acastles91/menelaos/menelaos/menelaos-v2.kicad_pcb

## KiCad design menelaos/menelaos-v2.kicad_pcb (2021-11-27)

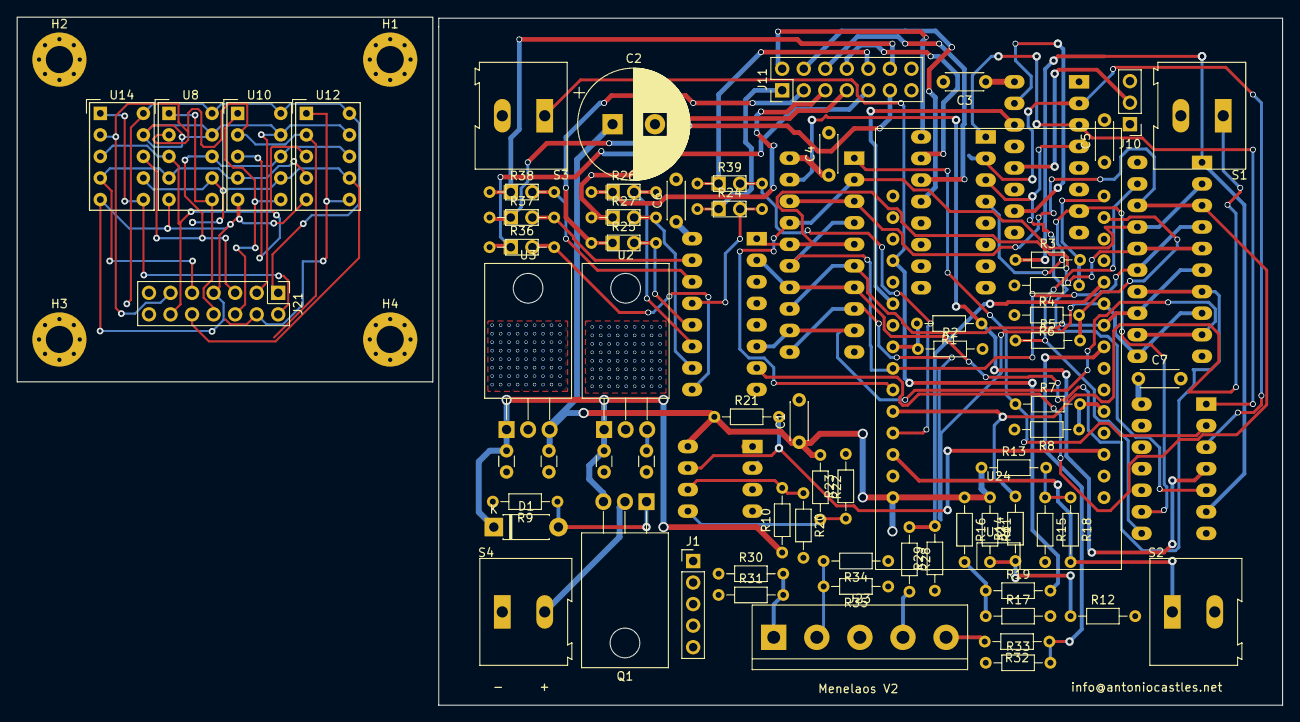
[picture p1: board menelaos-v2.kicad_pcb from above]

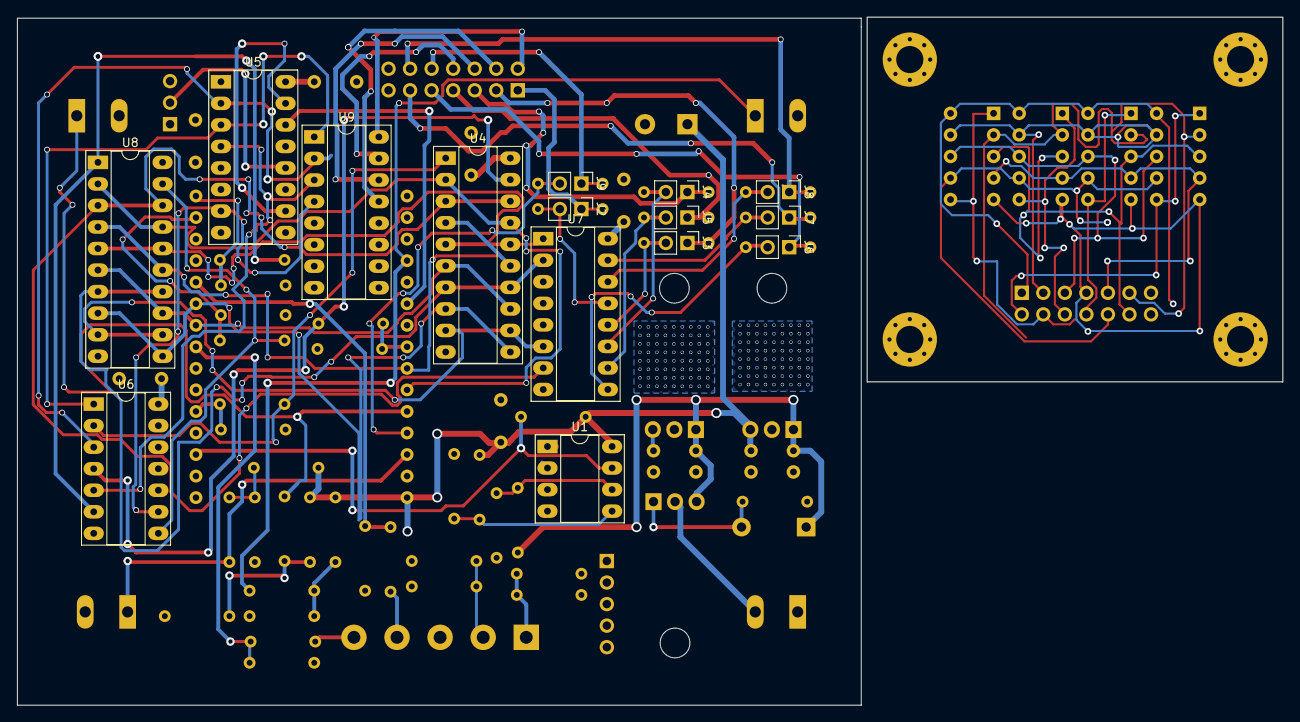
[picture p2: board menelaos-v2.kicad_pcb from below]

Board: 4 copper layers, 149.2 x 81.1 mm, 87 parts (15 on the bottom side), 64 nets.

Parts:
C1, C3, C4, C5, C6, C7: C; C_Disc_D4.3mm_W1.9mm_P5.00mm
C2: CP1; CP_Radial_D13.0mm_P5.00mm
D1: D_Zener-10V; D_DO-41_SOD81_P7.62mm_Horizontal
H1, H2, H3, H4: MountingHole; MountingHole_3.2mm_M3_Pad_Via
J1: Conn_01x05_Male; PinHeader_1x05_P2.54mm_Vertical
J2, J3, J4, J5, J6, J7, J8, J9: Conn_01x02_Male; PinHeader_1x02_P2.54mm_Vertical
J10: Conn_01x03_Male; PinHeader_1x03_P2.54mm_Vertical
J11, J21: Conn_02x07_Counter_Clockwise; PinHeader_2x07_P2.54mm_Vertical-counterclockwise
J23: DIN-5-TerminalBlock; TerminalBlock_bornier-5_P5.08mm
Murata-Ceramic-Capacitor-50v1-22uF1, Murata-Ceramic-Capacitor-50v1-22uF2, Murata-Ceramic-Capacitor-50v1-22uF3, Murata-Ceramic-Capacitor-50v1-22uF4: C; C_Disc_D3.0mm_W1.6mm_P2.50mm
Q1: IRF5305-Reverse-Polarity; TO-220-3_Horizontal_TabDown
R1, R3, R5, R7, R11, R13, R16: 5K; R_Axial_DIN0204_L3.6mm_D1.6mm_P7.62mm_Horizontal
R2, R4, R6, R8, R12, R14, R15, R17, R18, R19: 10K; R_Axial_DIN0204_L3.6mm_D1.6mm_P7.62mm_Horizontal
R9: 100K; R_Axial_DIN0204_L3.6mm_D1.6mm_P7.62mm_Horizontal
R10, R20, R21, R22, R23, R24, R25, R26, R27, R36, R37, R38, R39: R; R_Axial_DIN0204_L3.6mm_D1.6mm_P7.62mm_Horizontal
R28, R32: 50; R_Axial_DIN0204_L3.6mm_D1.6mm_P7.62mm_Horizontal
R29, R30, R33, R34: 220; R_Axial_DIN0204_L3.6mm_D1.6mm_P7.62mm_Horizontal
R31, R35: 100; R_Axial_DIN0204_L3.6mm_D1.6mm_P7.62mm_Horizontal
S1, S2, S3, S4: Generic-Switch; TerminalBlock_Altech_AK300-2_P5.00mm
U1: LM393; DIP-8_W7.62mm_Socket_LongPads
U2, U3: L7805; TO-220-3_Horizontal_TabDown
U4, U8#2: 74HCT244; DIP-20_W7.62mm_Socket_LongPads
U5: 74HC4017E; DIP-16_W7.62mm_Socket_LongPads
U6: 74HC04; DIP-14_W7.62mm_Socket_LongPads
U7: 74HC4511E; DIP-16_W7.62mm_Socket_LongPads
U8, U10, U12, U14: HDSP-7503; HDSP-A151
U9: ULN2003; DIP-16_W7.62mm_Socket_LongPads
U24: ESP32-WROOM-32D; ESP32-DEVKIT

Connections:
+5VL: C1.1, C2.1, Murata-Ceramic-Capacitor-50v1-22uF4.1, R11.1, R13.1, R16.1, R21.1, R22.1, U1.8, U3.3, U24.15
+12V: D1.1, Murata-Ceramic-Capacitor-50v1-22uF1.1, Murata-Ceramic-Capacitor-50v1-22uF2.1, Q1.3, R10.1, U2.1, U3.1
/7-segmet-display/BCD_out1: U4.3, U4.18, U7.7, U8#2.3, U8#2.18
/7-segmet-display/BCD_out2: U4.5, U4.16, U7.1, U8#2.5, U8#2.16
/7-segmet-display/BCD_out3: U4.7, U4.14, U7.2, U8#2.7, U8#2.14
/7-segmet-display/BCD_out4: U4.9, U4.12, U7.6, U8#2.9, U8#2.12
GND: C1.2, C2.2, C3.2, C4.2, C5.2, C6.2, C7.2, J1.1, J1.2, J1.3, J1.4, J1.5, J10.3, Murata-Ceramic-Capacitor-50v1-22uF1.2, Murata-Ceramic-Capacitor-50v1-22uF2.2, Murata-Ceramic-Capacitor-50v1-22uF3.2, Murata-Ceramic-Capacitor-50v1-22uF4.2, R2.2, R4.2, R6.2, R8.2, R9.2, R12.2, R15.2, R17.2, R20.2, R23.2, R29.1, R30.1, R31.1, R33.1, R34.1, R35.1, S1.2, S2.2, S3.2, S4.1, U1.4, U2.2, U3.2, U4.10, U5.8, U5.13, U6.7, U7.5, U7.8, U8#2.10, U9.8, U24.14, U24.17
unnamed: D1.2, Q1.1, R9.1
unnamed: J10.2, U5.12
unnamed: Q1.2, S4.2
unnamed: R10.2, R20.1, U1.6
unnamed: R11.2, R12.1, R14.1
unnamed: R13.2, R15.1, R18.1
unnamed: R16.2, R17.1, R19.1
unnamed: R22.2, R23.1, U1.5
unnamed: U5.2, U6.3, U9.2
unnamed: U5.3, U6.1, U9.1
unnamed: U5.4, U6.5, U9.3
unnamed: U5.7, U6.9, U9.4
unnamed: U5.10, U5.15
_a: J2.1, J11.1, R24.1
_a1: U4.2, U4.17, U8#2.2, U8#2.17, U24.10
_a2: U4.4, U4.15, U8#2.4, U8#2.15, U24.9
_a3: U4.6, U4.13, U8#2.6, U8#2.13, U24.24
_a4: U4.8, U4.11, U8#2.8, U8#2.11, U24.25
_b: J3.1, J11.2, R25.1
_c: J4.1, J11.3, R26.1
_chA: R28.1, R29.2, U24.26
_chB: R32.1, R33.2, U24.23
_clk: U5.14, U24.6
_config: R19.2, S3.1, U24.4
_d: J5.1, J11.4, R27.1
_dp: J9.1, J11.10, R39.1
_dpBoard: J9.2, R39.2, U24.12
_e: J6.1, J11.5, R36.1
_f: J7.1, J11.6, R37.1
_g: J8.1, J11.9, R38.1
_hundreds: R5.1, U6.8, U8#2.19
_hundredsBoard: R5.2, R6.1, U24.29
_mode: R18.2, S2.1, U24.13
_ones: R1.1, U4.19, U6.4
_onesBoard: R1.2, R2.1, U24.8
_save: R21.2, U1.7, U24.18
_tens: R3.1, U6.6, U8#2.1
_tensBoard: R3.2, R4.1, U24.30
_thousands: R7.1, U4.1, U6.2
_thousandsBoard: R7.2, R8.1, U24.20
_zero: R14.2, S1.1, U24.11
a: J2.2, R24.2, U7.13
b: J3.2, R25.2, U7.12
black: J23.5, R32.2
blue: C3.1, C4.1, C5.1, C6.1, C7.1, J10.1, J23.3, Murata-Ceramic-Capacitor-50v1-22uF3.1, U2.3, U4.20, U5.16, U6.14, U7.3, U7.4, U7.16, U8#2.20
c: J4.2, R26.2, U7.11
d: J5.2, R27.2, U7.10
e: J6.2, R36.2, U7.9
f: J7.2, R37.2, U7.15
g: J8.2, R38.2, U7.14
hundreds: J11.13, U9.13
ones: J11.11, U9.15
red: J23.1, R30.2, R31.2
tens: J11.12, U9.14
thousands: J11.14, U9.16
white: J23.2, R34.2, R35.2
yellow: J23.4, R28.2
