acastles91/menelaos/menelaos/menelaos-v1.kicad_pcb

## KiCad design menelaos/menelaos-v1.kicad_pcb (2021-11-03, an earlier design)

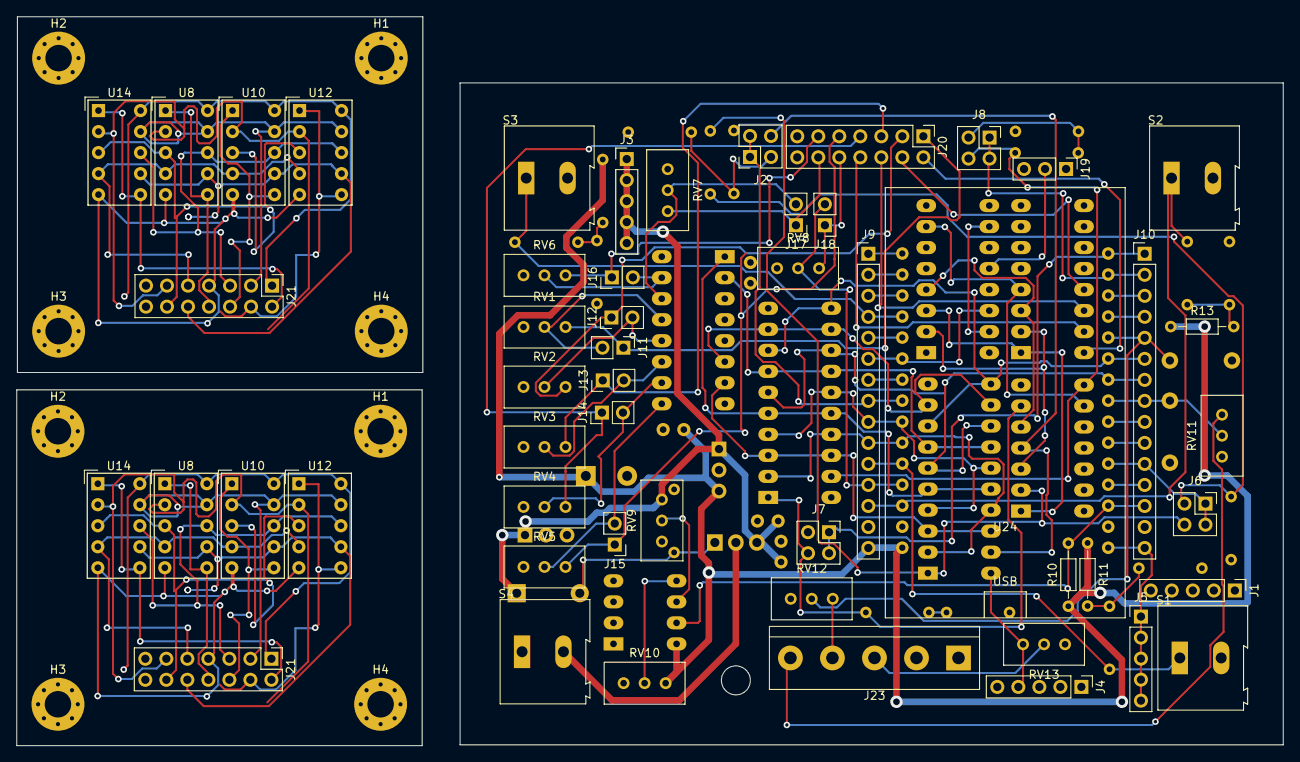
[picture p3: board menelaos-v1.kicad_pcb from above]

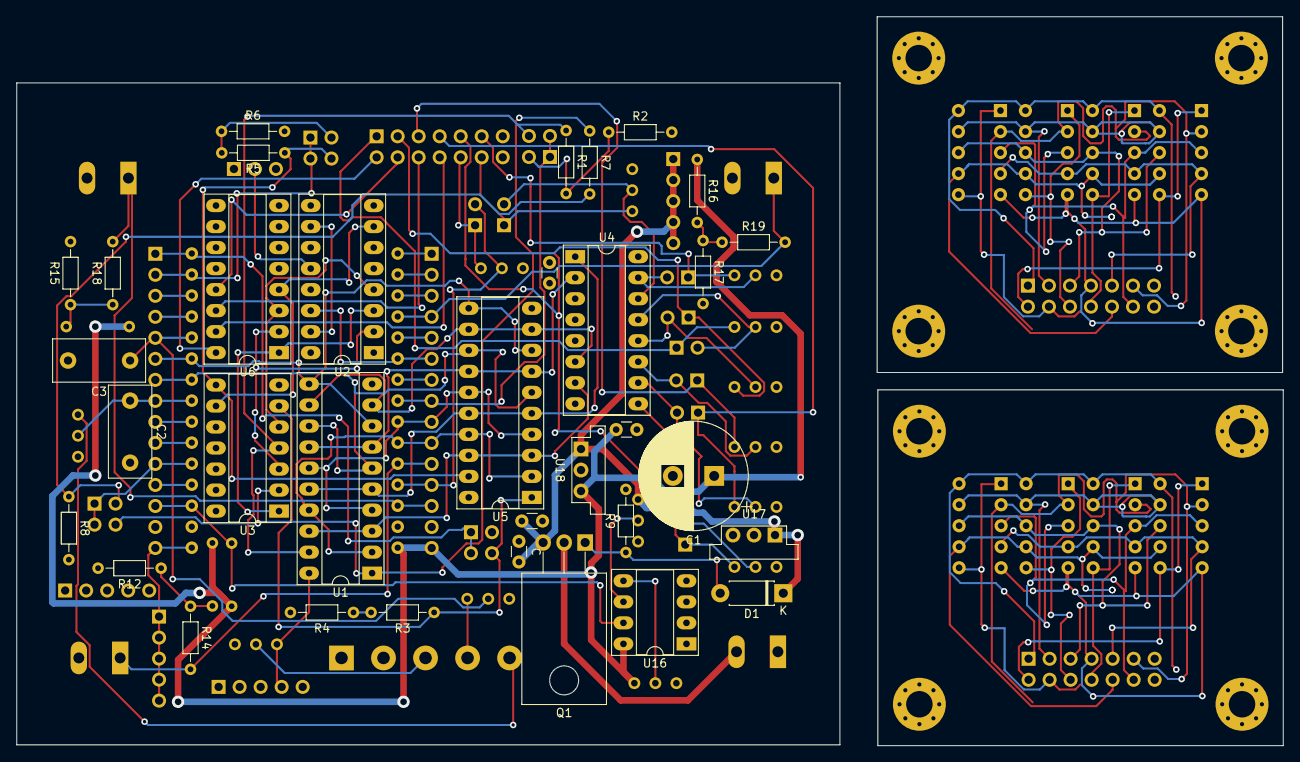
[picture p4: board menelaos-v1.kicad_pcb from below]

Board: 4 copper layers, 99.5 x 80.0 mm, 94 parts (34 on the bottom side), 90 nets.

Parts:
C1: CP1; CP_Radial_D13.0mm_P5.00mm
C2, C3: C; C_Disc_D11.0mm_W5.0mm_P7.50mm
D1: D_Zener-10V; D_DO-41_SOD81_P7.62mm_Horizontal
H1, H1#2, H2, H2#2, H3, H3#2, H4, H4#2: MountingHole; MountingHole_3.2mm_M3_Pad_Via
J1, J3, J4, J5: Conn_01x05_Male; PinHeader_1x05_P2.54mm_Vertical
J2, J6, J7, J8: Conn_02x02_Counter_Clockwise; PinSocket_2x02_P2.54mm_Vertical_CounterClockWise
J9, J10: Conn_01x15_Male; PinHeader_1x15_P2.54mm_Vertical
J11, J12, J13, J14, J15, J16, J17, J18: Conn_01x02_Male; PinHeader_1x02_P2.54mm_Vertical
J19: Conn_01x03_Male; PinHeader_1x03_P2.54mm_Vertical
J20, J21, J21#2: Conn_02x07_Counter_Clockwise; PinHeader_2x07_P2.54mm_Vertical-counterclockwise
J23: DIN-5-TerminalBlock; TerminalBlock_bornier-5_P5.08mm
Murata-Ceramic-Capacitor-50v1-22uF1, Murata-Ceramic-Capacitor-50v1-22uF2, Murata-Ceramic-Capacitor-50v1-22uF3, Murata-Ceramic-Capacitor-50v1-22uF4: C; C_Disc_D3.0mm_W1.6mm_P2.50mm
Q1: IRF5305-Reverse-Polarity; TO-220-3_Horizontal_TabDown
R1, R3, R5, R7, R11, R13, R16: 5K; R_Axial_DIN0204_L3.6mm_D1.6mm_P7.62mm_Horizontal
R2, R4, R6, R8, R12, R14, R15, R17, R18, R19: 10K; R_Axial_DIN0204_L3.6mm_D1.6mm_P7.62mm_Horizontal
R9: 100K; R_Axial_DIN0204_L3.6mm_D1.6mm_P7.62mm_Horizontal
R10: R; R_Axial_DIN0204_L3.6mm_D1.6mm_P7.62mm_Horizontal
RV1, RV2, RV3, RV4, RV5, RV6, RV7, RV8, RV9, RV10, RV11, RV12, RV13: R_POT_TRIM; Potentiometer_Bourns_3296W_Vertical
S1, S2, S3, S4: Generic-Switch; TerminalBlock_Altech_AK300-2_P5.00mm
U1, U5: 74HCT244; DIP-20_W7.62mm_Socket_LongPads
U2: 74HC4017E; DIP-16_W7.62mm_Socket_LongPads
U3: 74HC04; DIP-14_W7.62mm_Socket_LongPads
U4: 74HC4511E; DIP-16_W7.62mm_Socket_LongPads
U6: ULN2003; DIP-16_W7.62mm_Socket_LongPads
U8, U8#2, U10, U10#2, U12, U12#2, U14, U14#2: HDSP-7503; HDSP-A151
U16: LM393; DIP-8_W7.62mm_Socket_LongPads
U17, U18: OKI-78SR-5v; Converter_DCDC_muRata_OKI-78SR_Vertical
U24: ESP32-WROOM-32D; ESP32-DEVKIT

Connections:
+3V3: J5.1, J5.2, J5.3, J5.4, J5.5, J10.15, U24.16
+5VL: C1.1, J9.15, Murata-Ceramic-Capacitor-50v1-22uF4.1, R10.1, R11.1, R13.1, R16.1, RV10.1, U16.8, U18.3, U24.15
+5VP: J4.1, J4.2, J4.3, J4.4, J4.5, J19.1, Murata-Ceramic-Capacitor-50v1-22uF3.1, RV13.1, U1.20, U2.16, U3.14, U4.3, U4.4, U4.16, U5.20, U17.3
+12V: D1.1, J3.1, J3.2, J3.3, J3.4, J3.5, Murata-Ceramic-Capacitor-50v1-22uF1.1, Murata-Ceramic-Capacitor-50v1-22uF2.1, Q1.3, RV9.1, U17.1, U18.1
+a: J21#2.1, U8#2.10, U10#2.10, U12#2.10, U14#2.10
+b: J21#2.2, U8#2.9, U10#2.9, U12#2.9, U14#2.9
+c: J21#2.3, U8#2.8, U10#2.8, U12#2.8, U14#2.8
+d: J21#2.4, U8#2.5, U10#2.5, U12#2.5, U14#2.5
+dp: J21#2.10, U8#2.7, U10#2.7, U12#2.7, U14#2.7
+e: J21#2.5, U8#2.4, U10#2.4, U12#2.4, U14#2.4
+f: J21#2.6, U8#2.2, U10#2.2, U12#2.2, U14#2.2
+g: J21#2.9, U8#2.3, U10#2.3, U12#2.3, U14#2.3
+hundreds: J21#2.13, U12#2.1, U12#2.6
+ones: J21#2.11, U8#2.1, U8#2.6
+tens: J21#2.12, U10#2.1, U10#2.6
+thousands: J21#2.14, U14#2.1, U14#2.6
/7-segmet-display/BCD_out1: U1.3, U1.18, U4.7, U5.3, U5.18
/7-segmet-display/BCD_out2: U1.5, U1.16, U4.1, U5.5, U5.16
/7-segmet-display/BCD_out3: U1.7, U1.14, U4.2, U5.7, U5.14
/7-segmet-display/BCD_out4: U1.9, U1.12, U4.6, U5.9, U5.12
unnamed: D1.2, Q1.1, R9.1
unnamed: J9.1, U24.1
unnamed: J9.2, U24.2
unnamed: J9.3, U24.3
unnamed: J9.5, U24.5
unnamed: J9.7, U24.7
unnamed: J10.3, U24.28
unnamed: J10.4, U24.27
unnamed: J10.9, U24.22
unnamed: J10.10, U24.21
unnamed: J10.12, U24.19
unnamed: J19.2, U2.12
unnamed: R11.2, R12.1, R14.1
unnamed: R13.2, R15.1, R18.1
unnamed: R16.2, R17.1, R19.1
unnamed: RV9.2, U16.6
unnamed: RV10.2, U16.5
unnamed: U2.2, U3.3, U6.2
unnamed: U2.3, U3.1, U6.1
unnamed: U2.4, U3.5, U6.3
unnamed: U2.7, U3.9, U6.4
unnamed: U2.10, U2.15
POWER-IN+: Q1.2, S4.2
POWER-IN-: C1.2, C2.2, C3.2, J1.1, J1.2, J1.3, J1.4, J1.5, J9.14, J10.14, J19.3, J23.1, J23.2, Murata-Ceramic-Capacitor-50v1-22uF1.2, Murata-Ceramic-Capacitor-50v1-22uF2.2, Murata-Ceramic-Capacitor-50v1-22uF3.2, Murata-Ceramic-Capacitor-50v1-22uF4.2, R2.2, R4.2, R6.2, R8.2, R9.2, R12.2, R15.2, R17.2, RV1.3, RV2.3, RV3.3, RV4.3, RV5.3, RV6.3, RV7.3, RV8.3, RV9.3, RV10.3, RV11.3, RV12.3, RV13.3, S1.2, S2.2, S3.2, S4.1, U1.10, U2.8, U2.13, U3.7, U4.5, U4.8, U5.10, U6.8, U16.4, U17.2, U18.2, U24.14, U24.17
_a: J11.1, J20.1, RV1.1
_a1: J9.10, U1.2, U1.17, U5.2, U5.17, U24.10
_a2: J9.9, U1.4, U1.15, U5.4, U5.15, U24.9
_a3: J10.7, U1.6, U1.13, U5.6, U5.13, U24.24
_a4: J10.6, U1.8, U1.11, U5.8, U5.11, U24.25
_b: J12.1, J20.2, RV2.1
_c: J13.1, J20.3, RV3.1
_chA: C3.1, J10.5, RV12.2, U24.26
_chB: C2.1, J10.8, RV11.2, U24.23
_clk: J9.6, U2.14, U24.6
_config: J9.4, R19.2, S3.1, U24.4
_d: J14.1, J20.4, RV4.1
_dp: J18.1, J20.10, RV8.1
_dpBoard: J9.12, J18.2, RV8.2, U24.12
_e: J15.1, J20.5, RV5.1
_f: J16.1, J20.6, RV6.1
_g: J17.1, J20.9, RV7.1
_hundreds: J8.2, R5.1, U3.8, U5.19
_hundredsBoard: J8.3, J8.4, J10.2, U24.29
_mode: J9.13, R18.2, S2.1, U24.13
_ones: J2.2, R1.1, U1.19, U3.4
_onesBoard: J2.3, J2.4, J9.8, U24.8
_save: J10.13, R10.2, U16.7, U24.18
_tens: J7.2, R3.1, U3.6, U5.1
_tensBoard: J7.3, J7.4, J10.1, U24.30
_thousands: J6.2, R7.1, U1.1, U3.2
_thousandsBoard: J6.3, J6.4, J10.11, U24.20
_zero: J9.11, R14.2, S1.1, U24.11
a: J11.2, RV1.2, U4.13
b: J12.2, RV2.2, U4.12
c: J13.2, RV3.2, U4.11
d: J14.2, RV4.2, U4.10
e: J15.2, RV5.2, U4.9
f: J16.2, RV6.2, U4.15
g: J17.2, RV7.2, U4.14
gray: J23.5, RV11.1
hundreds: J20.13, U6.13
hundreds33: J8.1, R5.2, R6.1
ones: J20.11, U6.15
ones33: J2.1, R1.2, R2.1
tens: J20.12, U6.14
tens33: R3.2, R4.1
thousands: J20.14, U6.16
thousands33: J6.1, R7.2, R8.1
white: J23.3, RV13.2
yellow: J23.4, RV12.1
