acastles91/menelaos/menelaos_stm32/menelaos-rev-4/menelaos-rev-4.kicad_pcb

## KiCad design menelaos_stm32/menelaos-rev-4/menelaos-rev-4.kicad_pcb (2024-06-01)

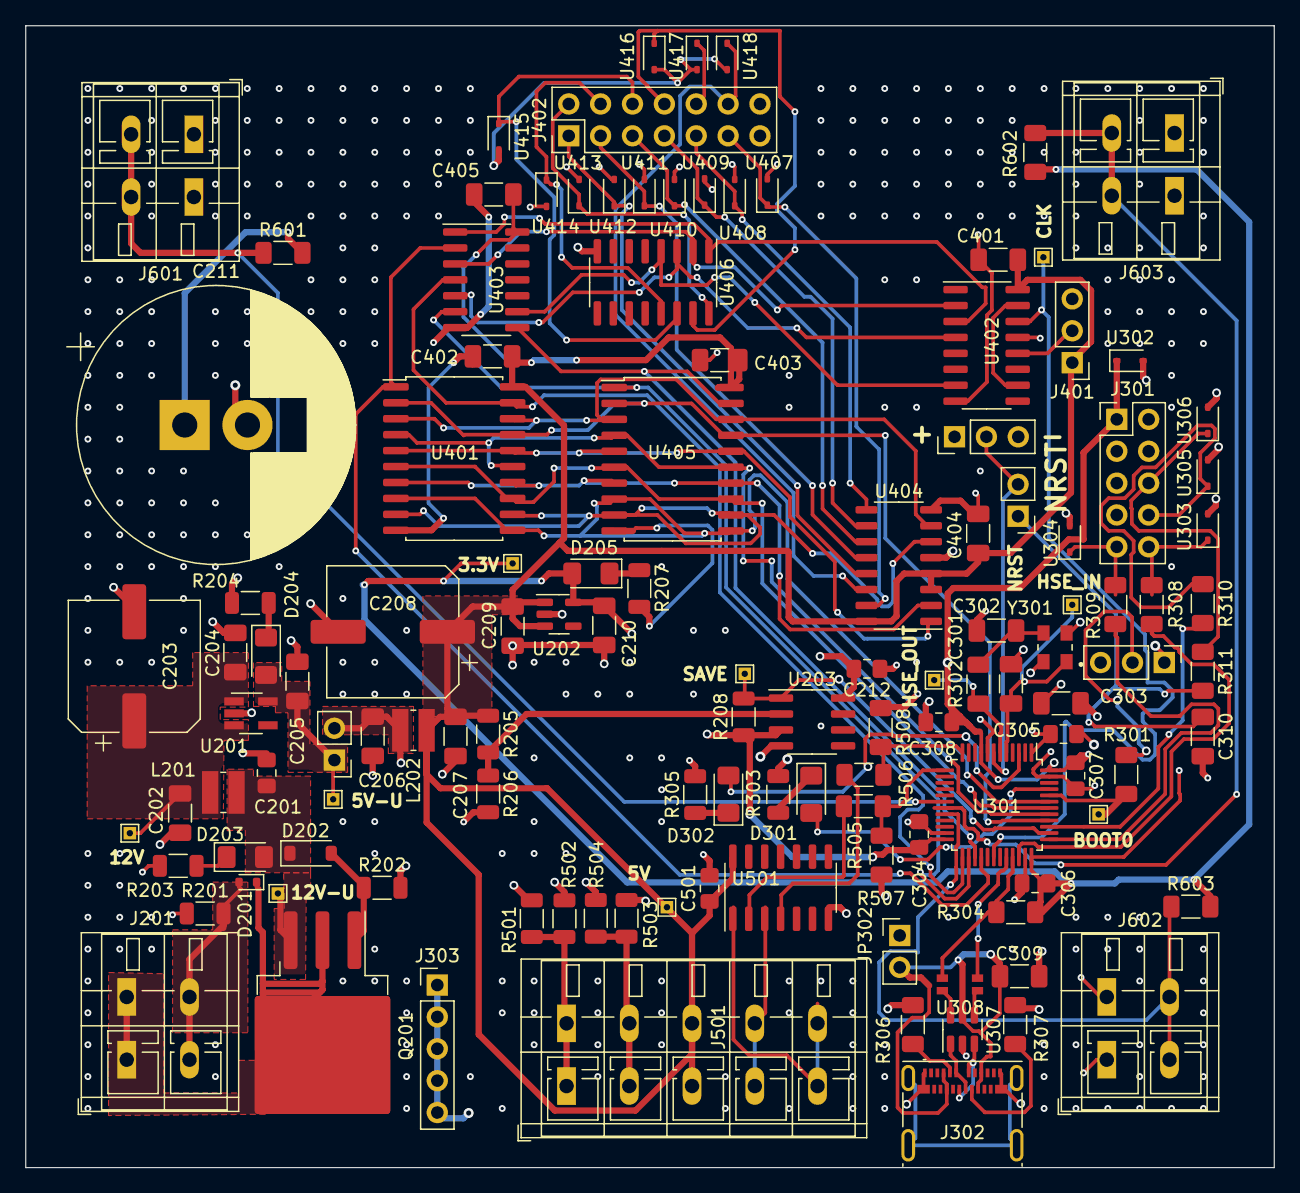
[picture p5: board menelaos-rev-4.kicad_pcb from above]

Board: 4 copper layers, 99.5 x 91.0 mm, 124 parts (0 on the bottom side), 84 nets.

Parts:
C201, C212: 0.1uF; C_0805_2012Metric_Pad1.18x1.45mm_HandSolder
C202, C205, C206, C207, C404: 0.1uF; C_1206_3216Metric_Pad1.33x1.80mm_HandSolder
C203, C208: C_Polarized; CP_Elec_10x12.6
C204: 0.33uF; C_1206_3216Metric_Pad1.33x1.80mm_HandSolder
C209, C210: 1uF; C_1206_3216Metric_Pad1.33x1.80mm_HandSolder
C211: CP1; CP_Radial_D22.0mm_P5.00mm_SnapIn
C301, C302: 12p; C_1206_3216Metric_Pad1.33x1.80mm_HandSolder
C303: 10u; C_1206_3216Metric_Pad1.33x1.80mm_HandSolder
C304, C305, C306, C307, C308: 100n; C_0805_2012Metric_Pad1.18x1.45mm_HandSolder
C309: 10p; C_1206_3216Metric_Pad1.33x1.80mm_HandSolder
C310: 100n; C_1206_3216Metric_Pad1.33x1.80mm_HandSolder
C401, C402, C403, C405: C; C_1206_3216Metric_Pad1.33x1.80mm_HandSolder
C501: C; C_0805_2012Metric_Pad1.18x1.45mm_HandSolder
D201: ESD5Zxx; D_SOD-523
D202: D_Zener-10V; D_SOD-123
D203, D204, D205, D301, D302: LED; LED_1206_3216Metric_Pad1.42x1.75mm_HandSolder
J201, J601, J602, J603: Screw_Terminal_01x02; TerminalBlock_WAGO_236-402_1x02_P5.00mm_45Degree
J301: Conn_02x05_Counter_Clockwise; PinHeader_2x05_P2.54mm_Vertical
J302: USB_C_Receptacle_USB2.0; USB_C_Receptacle_Molex_105450-0101
J303: Conn_01x05_Male; PinHeader_1x05_P2.54mm_Vertical
J401: Conn_01x03_Male; PinHeader_1x03_P2.54mm_Vertical
J402: Conn_02x07_Counter_Clockwise; PinHeader_2x07_P2.54mm_Vertical-CounterClockWise
J501: DIN-5-TerminalBlock; TerminalBlock_WAGO_236-405_1x05_P5.00mm_45Degree
JP201, JP302: Jumper_2_Open; PinHeader_1x02_P2.54mm_Vertical
JP301, JP304: Jumper_3_Open; PinHeader_1x03_P2.54mm_Vertical
JP303: Jumper_2_Bridged; PinHeader_1x02_P2.54mm_Vertical
L201, L202: L; L_Wuerth_MAPI-3015
Q201: IRF5305-Reverse-Polarity; TO-263-3_TabPin2
R201: 0; R_1206_3216Metric
R202: 100K; R_1206_3216Metric
R203, R204: R_US; R_1206_3216Metric
R205: 5K; R_1206_3216Metric
R206: 10K; R_1206_3216Metric
R207, R303, R305: R100; R_1206_3216Metric
R208: R; R_1206_3216Metric
R301, R505, R506, R507, R508, R601, R602, R603: R10k; R_1206_3216Metric_Pad1.30x1.75mm_HandSolder
R302: R0; R_1206_3216Metric_Pad1.30x1.75mm_HandSolder
R304: R1k5; R_1206_3216Metric_Pad1.30x1.75mm_HandSolder
R306, R307: R5k1; R_1206_3216Metric_Pad1.30x1.75mm_HandSolder
R308, R309, R310, R311: 49R9; R_1206_3216Metric_Pad1.30x1.75mm_HandSolder
R501, R503: 220; R_1206_3216Metric
R502, R504: 100; R_1206_3216Metric
TP201, TP202, TP203, TP204, TP205, TP206, TP301, TP302, TP303, TP401: TestPoint; TestPoint_THTPad_1.0x1.0mm_Drill0.5mm
U201: NCP718-LDO_Regulator; SOT-23-5_HandSoldering
U202: MIC5504-3.3YM5; SOT-23-5
U203: LM2903; SOIC-8_3.9x4.9mm_P1.27mm
U301: STM32F103CBTx; LQFP-48_7x7mm_P0.5mm
U302, U303, U304, U305, U306, U407, U408, U409, U410, U411, U412, U413, U414, U415, U416, U417, U418: PESD3V3L1BA-Bidirectional_Diode; D_SOD-323
U307: USBLC6-2SC6; SOT-23-6
U308: SRF3216A-Common_Mode_Choke; Bourns_SRF3216A
U401, U405: 74HCT244; SOIC-20W_7.5x12.8mm_P1.27mm
U402: 74HC4017E; SOIC-16_3.9x9.9mm_P1.27mm
U403: 74HC04; SOIC-14_3.9x8.7mm_P1.27mm
U404: 74HC4511E; SO-16_3.9x9.9mm_P1.27mm
U406: ULN2003; SOIC-16_3.9x9.9mm_P1.27mm
U501: 74HC14; SOIC-14_3.9x8.7mm_P1.27mm
Y301: CX3225SB16000H0PSTC1-Crystal; OSCCC320X250X60N

Connections:
+3.3V: C210.1, C211.1, C212.2, C303.1, C304.1, C305.1, C306.1, C307.1, C308.1, D205.2 (A), J301.1, JP301.3 (B), JP304.1 (A), R208.1, R304.2, R601.2, R602.2, R603.2, TP206.1, U202.5 (VOUT), U203.3 (+), U203.8 (V+), U301.1 (VBAT), U301.9 (VDDA), U301.24 (VDD), U301.36 (VDD), U301.48 (VDD), U302.1
+12V: C202.1, C203.1, C204.1, L201.2, TP202.1, U201.1 (Vin), U201.3 (EN)
/cable/SCHMITT_A: R506.1, U501.4
/cable/SCHMITT_B: R505.1, U501.2
/mcu/BOOT0: R301.2, TP303.1, U301.44 (BOOT0)
/mcu/BOOT_JUMPER: JP301.2 (C), R301.1
/mcu/CONN_NRST: J301.6, R311.1, U306.1
/mcu/CONN_SWCLK: J301.9, R309.1, U304.1
/mcu/CONN_SWDIO: J301.10, R308.1, U303.1
/mcu/CONN_SWO: J301.8, R310.1, U305.1
/mcu/HSE_IN: C301.1, TP301.1, U301.5 (PD0), Y301.1
/mcu/HSE_OUT: R302.1, TP302.1, U301.6 (PD1)
/mcu/JUMPER_NRST: C310.1, JP303.1 (A), R311.2
/mcu/MCU_LED1: D301.2 (A), U301.45 (PB8)
/mcu/MCU_LED1-K: D301.1 (K), R303.1
/mcu/MCU_LED2: D302.2 (A), U301.3 (PC14)
/mcu/MCU_LED2-K: D302.1 (K), R305.1
/mcu/MCU_NRST: JP303.2 (B), JP304.2 (C), U301.7 (NRST)
/mcu/MCU_SWCLK: R309.2, U301.37 (PA14)
/mcu/MCU_SWDIO: R308.2, U301.34 (PA13)
/mcu/MCU_SWO: R310.2, U301.39 (PB3)
/mcu/USB_CMC_D+: U307.6 (I/O1), U308.3
/mcu/USB_CMC_D-: U307.4 (I/O2), U308.4
/mcu/USB_CONN_CC1: J302.A5 (CC1), R306.2
/mcu/USB_CONN_CC2: J302.B5 (CC2), R307.2
/mcu/USB_CONN_D+: J302.A6 (D+), J302.B6 (D+), U307.1 (I/O1)
/mcu/USB_CONN_D-: J302.A7 (D-), J302.B7 (D-), U307.3 (I/O2)
/mcu/USB_D+: R304.1, U301.33 (PA12), U308.2
/mcu/USB_D-: U301.32 (PA11), U308.1
/mcu/XTAL_IN: C302.1, R302.2, Y301.3
/power/5V-Jumper: C205.1, D204.2 (A), JP201.1 (A), TP203.1, U201.5 (Vout)
/power/12V-Unfiltered: C201.1, D202.1 (K), D203.2 (A), L201.1, Q201.3 (S), TP201.1
/power/12V-Unfiltered__LED_K: D203.1 (K), R203.2
/power/LDO2_LED_K: D205.1 (K), R207.1
/power/LDO_LED_K: D204.1 (K), R204.2
/power/POL-FET-D: D201.1 (K), J201.1, Q201.2 (D)
/power/POL-FET-G: D202.2 (A), Q201.1 (G), R202.1
/power/PowerIn-: D201.2 (A), J201.2, R201.2
/power/V-REF: R205.2, R206.1, U203.2 (-)
/seven-segment-display/4017_RST: U402.10 (4), U402.15 (MASTER_RESET)
/seven-segment-display/4017_TC: J401.2, U402.12 (TERMINAL_COUNT)
/seven-segment-display/BCD_out1: U401.3 (2Y0), U401.18 (1Y0), U404.7 (D0), U405.3 (2Y0), U405.18 (1Y0)
/seven-segment-display/BCD_out2: U401.5 (2Y1), U401.16 (1Y1), U404.1 (D1), U405.5 (2Y1), U405.16 (1Y1)
/seven-segment-display/BCD_out3: U401.7 (2Y2), U401.14 (1Y2), U404.2 (D2), U405.7 (2Y2), U405.14 (1Y2)
/seven-segment-display/BCD_out4: U401.9 (2Y3), U401.12 (1Y3), U404.6 (D3), U405.9 (2Y3), U405.12 (1Y3)
/seven-segment-display/COUNT_0: U402.3 (0), U403.1, U406.1 (I1)
/seven-segment-display/COUNT_1: U402.2 (1), U403.3, U406.2 (I2)
/seven-segment-display/COUNT_2: U402.4 (2), U403.5, U406.3 (I3)
/seven-segment-display/COUNT_3: U402.7 (3), U403.9, U406.4 (I4)
GND: C201.2, C202.2, C203.2, C204.2, C205.2, C206.2, C207.2, C208.2, C209.2, C210.2, C211.2, C212.1, C301.2, C302.2, C303.2, C304.2, C305.2, C306.2, C307.2, C308.2, C309.1, C310.2, C401.2, C402.2, C403.2, C404.2, C405.2, C501.2, J301.2, J301.3, J301.5, J302.A1 (GND), J302.A12 (GND), J302.B1 (GND), J302.B12 (GND), J303.1, J303.2, J303.3, J303.4, J303.5, J401.3, J601.1, J602.1, J603.1, JP301.1 (A), JP304.3 (B), R201.1, R202.2, R203.1, R204.1, R206.2, R207.2, R303.2, R305.2, R306.1, R307.1, R501.1, R502.1, R503.1, R504.1, R507.1, R508.1, U201.2 (GND), U202.2 (GND), U203.4 (V-), U301.8 (VSSA), U301.23 (VSS), U301.35 (VSS), U301.47 (VSS), U302.2, U303.2, U304.2, U305.2, U306.2, U307.2 (GND), U401.10 (GND), U402.8 (GND), U402.13 (CLOCK_ENABLE), U403.7 (GND), U404.5 (LE), U404.8 (GND), U405.10 (GND), U406.8 (GND), U407.2, U408.2, U409.2, U410.2, U411.2, U412.2, U413.2, U414.2, U415.2, U416.2, U417.2, U418.2, U501.7 (GND), Y301.2 (GND), Y301.4 (GND__1)
Unfiltered_5V: C206.1, JP201.2 (B), JP302.1 (A), L202.1
VBUS: C309.2, J302.A4 (VBUS), J302.A9 (VBUS), J302.B4 (VBUS), J302.B9 (VBUS), JP302.2 (B), U307.5 (VBUS)
_a1: U301.40 (PB4), U401.2 (1A0), U401.17 (2A0), U405.2 (1A0), U405.17 (2A0)
_a2: U301.41 (PB5), U401.4 (1A1), U401.15 (2A1), U405.4 (1A1), U405.15 (2A1)
_a3: U301.42 (PB6), U401.6 (1A2), U401.13 (2A2), U405.6 (1A2), U405.13 (2A2)
_a4: U301.43 (PB7), U401.8 (1A3), U401.11 (2A3), U405.8 (1A3), U405.11 (2A3)
_chA: R506.2, R508.2, U301.12 (PA2)
_chB: R505.2, R507.2, U301.13 (PA3)
_clk: TP401.1, U301.30 (PA9), U402.14 (CLOCK)
_config: J603.2, R602.1, U301.19 (PB1)
_hundreds: U301.27 (PB14), U403.8, U405.19 (2OE)
_mode: J602.2, R603.1, U301.20 (PB2)
_ones: U301.25 (PB12), U401.19 (2OE), U403.4
_save: R208.2, TP205.1, U203.1, U301.38 (PA15)
_tens: U301.26 (PB13), U403.6, U405.1 (1OE)
_thousands: U301.28 (PB15), U401.1 (1OE), U403.2
_zero: J601.2, R601.1, U301.18 (PB0)
a: J402.1, U404.13 (a), U412.1
b: J402.2, U404.12 (b), U411.1
black: J501.5, U501.1
blue: C207.1, C208.1, C209.1, C401.1, C402.1, C403.1, C404.1, C405.1, C501.1, J401.1, J501.3, L202.2, R205.1, TP204.1, U202.1 (VIN), U202.3 (EN), U401.20 (VCC), U402.16 (Vcc), U403.14 (VCC), U404.3 (LT), U404.4 (BL), U404.16 (VCC), U405.20 (VCC), U501.14 (VCC)
c: J402.3, U404.11 (c), U410.1
d: J402.4, U404.10 (d), U409.1
dp: J402.10, U417.1
e: J402.5, U404.9 (e), U408.1
f: J402.6, U404.15 (f), U407.1
g: J402.9, U404.14 (g), U418.1
hundreds: J402.13, U406.13 (O4), U414.1
ones: J402.11, U406.15 (O2), U416.1
red: J501.1, R501.2, R502.2
tens: J402.12, U406.14 (O3), U415.1
thousands: J402.14, U406.16 (O1), U413.1
white: J501.2, R503.2, R504.2
yellow: J501.4, U501.3
