acastles91/menelaos/menelaos-fix/menelaos-fix.kicad_pcb

## KiCad design menelaos-fix/menelaos-fix.kicad_pcb (2024-06-01)

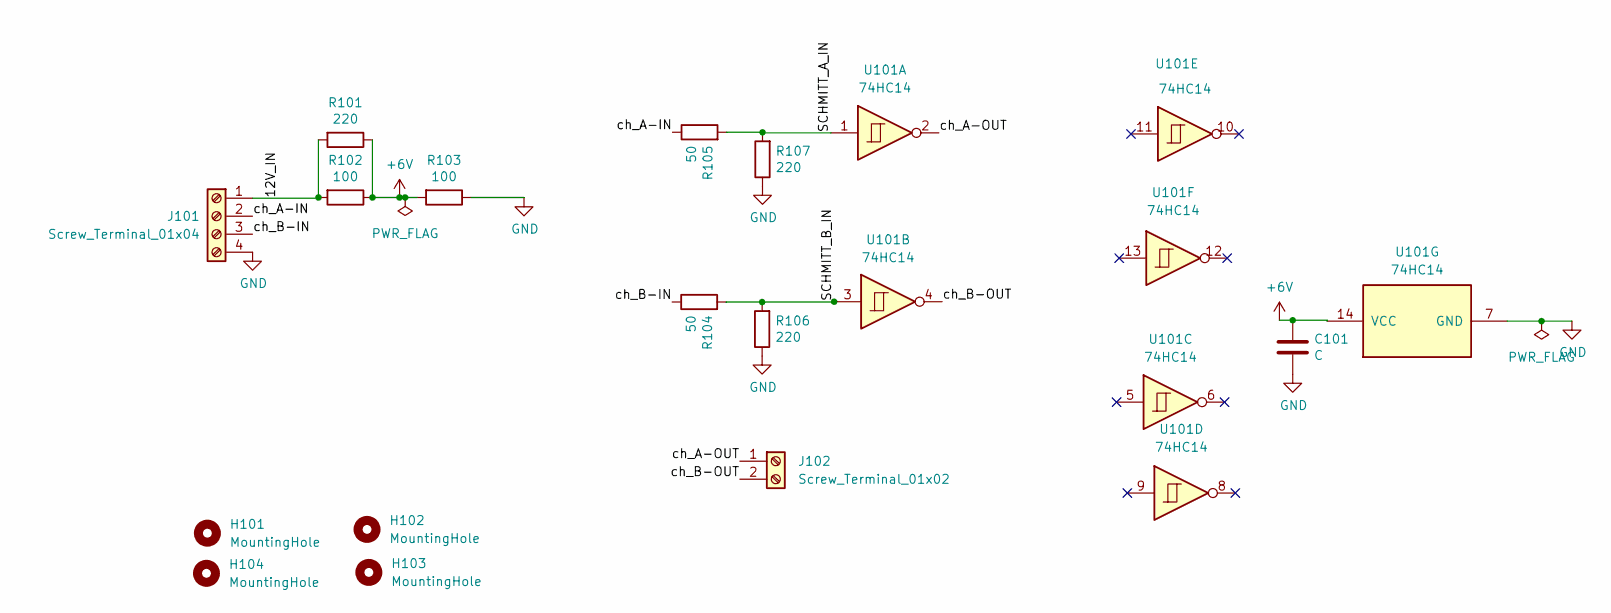
[picture p6: schematic menelaos-fix.kicad_sch]

Parts:
C101: C; C_Disc_D3.0mm_W1.6mm_P2.50mm
H101, H102, H103, H104: MountingHole; MountingHole_4.3mm_M4
J101: Screw_Terminal_01x04; TerminalBlock_Altech_AK300-4_P5.00mm
J102: Screw_Terminal_01x02; TerminalBlock_Altech_AK300-2_P5.00mm
R101, R106, R107: 220; R_Axial_DIN0204_L3.6mm_D1.6mm_P7.62mm_Horizontal
R102, R103: 100; R_Axial_DIN0204_L3.6mm_D1.6mm_P7.62mm_Horizontal
R104, R105: 50; R_Axial_DIN0204_L3.6mm_D1.6mm_P7.62mm_Horizontal
U101: 74HC14; DIP-14_W7.62mm_Socket; Digikey_PN 296-1643-5-ND

Connections:
+6V: C101.1, R101.1, R102.1, R103.2, U101.14 (VCC)
/12V_IN: J101.1, R101.2, R102.2
/SCHMITT_A_IN: R105.2, R107.2, U101.1
/SCHMITT_B_IN: R104.2, R106.2, U101.3
/ch_A-IN: J101.2, R105.1
/ch_A-OUT: J102.1, U101.2
/ch_B-IN: J101.3, R104.1
/ch_B-OUT: J102.2, U101.4
GND: C101.2, J101.4, R103.1, R106.1, R107.1, U101.7 (GND)

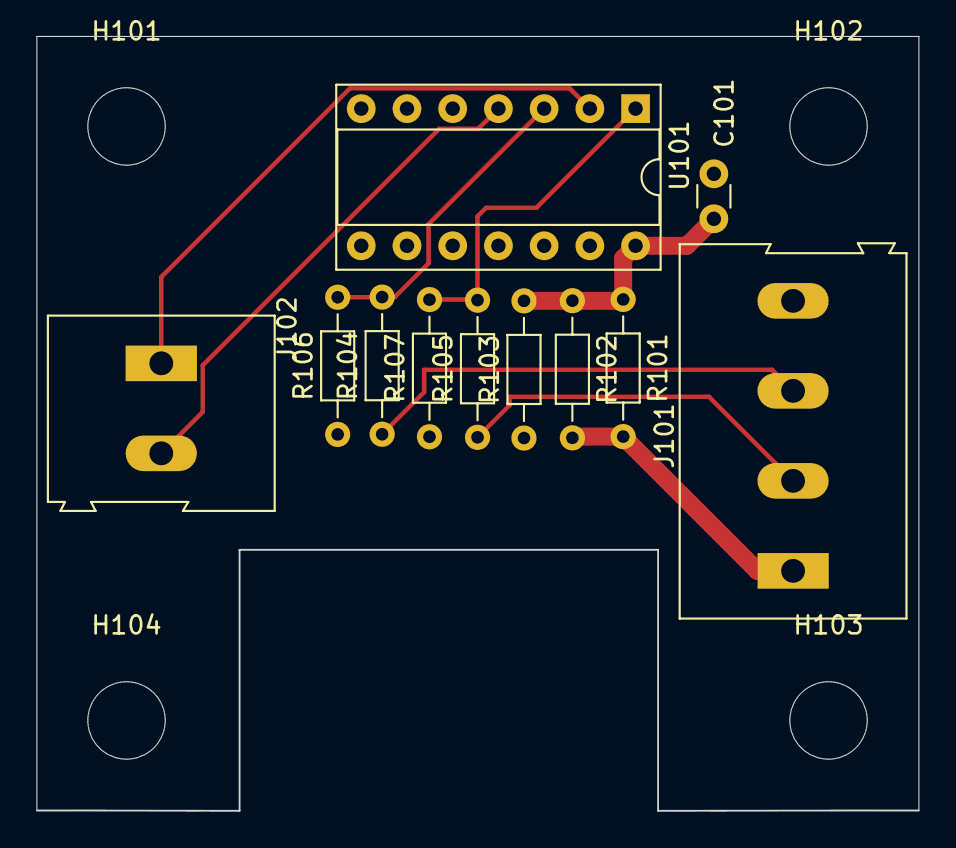
[picture p7: board menelaos-fix.kicad_pcb from above]

Board: 2 copper layers, 49.0 x 43.0 mm, 15 parts (0 on the bottom side), 9 nets.
