acastles91/menelaos/src/pinout.h

//Pinout


#define a1              27
#define a2              26
#define a3              18
#define a4              19
#define johnson         32
#define oe              14
#define dp              12
#define index_a1        0
#define index_a2        1
#define index_a3        2 
#define index_a4        3
#define toggleOe        13
#define toggleAddress   5
#define triggerCounter  21
#define onesPin         25
#define tensPin         23
#define hundredsPin     22
#define thousandsPin    4
#define chA             21
#define chB             5
#define savePin         15
#define EEPROM_SIZE     1
#define configPin       13  
#define builtinLed      2
#define zeroFunc        14
#define modePin         34
#define unused          35
