acastles91/menelaos/(commit log)

2021-11-03 menelaos before v2
    [7-segment-display.sch, Switches.sch, cable.sch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]
2021-11-27 This is the delivered version. Both the KiCad project and the code are what was delivered to UdK
    [7-segment-display-v2.sch, cable-v2.sch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]
2022-01-25 apparently fixed sleep bug
    [main.cpp]
2022-01-26 Previous commit still presented the problem. In this one I introduced an Idle mode, which happens during saving in shutdown. After waking up from sleep the program enters into an infinite loop in thi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
    [functions.h, main.cpp]
2024-06-01 before chat gpt intervention
    [7-segment-display-v2.kicad_sch, 7-segment-display-v2.sch, 7-segment-display.sch, Switches.kicad_sch, Switches.sch, cable-v2.kicad_sch, cable-v2.sch, cable.kicad_sch]
